abelbour/Abrepuertas/(commit log)

2026-07-19 HW: LED 12V con transistor BC337, actualizada cableado UTP
2026-07-19 HW: LED 12V con transistor BC337 en paneles internos, LED directo 3.3V en externos. Cableado UTP revisado.
2026-07-19 Add mermaid flowcharts and circuit diagrams
2026-07-19 Add circuit diagrams for external panel, gate lock, and emergency pedal
2026-07-19 Convert all flow diagrams to swimlane format
2026-07-20 Audit fixes: LED flash in internal_press, pull-up moved, independent cooldown, FC→OFF handler, emergency race flag, melody timing
2026-07-20 Fix swimlane 11.6: cooldown_externo_activo flag (was LED reposo)
2026-07-20 Reorganize bus: par 1 entradas, par 2 patio, par 3 broadcast, par 4 power
2026-07-20 fix: correcciones de bugs y optimizaciones ESP8266
    - Bugfix: on_boot relay ON para DESACTIVADO (puerta abierta al arrancar)
    - Bugfix: GPIO4 INPUT_PULLUP faltante en pulsador interno
    - Bugfix: emergency_alert usar while no bloqueante en vez de delay()
    - Bugfix: LED control usar make_call().perform() en lambdas
    - Bugfix: unificar rangos on_click interno (>4s sin límite)
    - Bugfix: rtttl.stop previo en unlock_gate para evitar conflicto PWM
    - Bugfix: emergency_alert LED flashea sincronizado con los tonos
    Optimizaciones ESP8266:
    - std::vector<std::string> melodies → PROGMEM melodies.h (~300B DRAM)
    - Cache int ms para doorbell/gate_open (evita FPU emulada)
    - gate_open_flash: mode parallel → s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
    [esphome-gate.yaml]
2026-07-20 feat: nuevas melodias RTTTL, apertura/emergencia RTTTL, bucle emergencia 60s
    - Nuevas 4 melodias de timbre en melodies.h
    - Sonido APERTURA (RTTTL) reemplaza pitidos PWM unlock_gate
    - Sonido EMERGENCIA (RTTTL) reemplaza alarma PWM 800/1200Hz
    - emergency_alert: bucle hasta 60s (12 ciclos) que se corta con
    pulsador interno o FC→OFF
    - Definicion sincronizada (SS5, SS7, diagramas 11.7-11.9)
    - Eliminado flash_and_beep_script (obsoleto tras migracion RTTTL)
    - Globals limpios (beep_pause, beep_step eliminados)
2026-07-20 feat: gate_open_flash beep a RTTTL, ACTIVAR/DESACTIVAR en melodies.h
    - BEEP_FLASH (B5 100ms via RTTTL) reemplaza ultimo PWM directo
    - ACTIVAR y DESACTIVAR movidos a melodies.h como PROGMEM
    - Todos los sonidos del sistema ahora son 100% RTTTL
    - Definicion actualizada (SS3.5, SS10)
2026-07-20 LED sincronizado con melodías en apertura y emergencia
    unlock_gate: LED parpadea 67ms ON/OFF siguiendo patrón c,p de APERTURA
    emergency_alert: LED parpadea 1067ms ON/133ms OFF siguiendo patrón c,8p
    Ambos bucles verifican FC cada 10ms (antes delay ciego en emergencia)
    unlock_gate restaura LED a 25% reposo al finalizar
2026-07-20 buzzer: solo salón (con pot), vestíbulo y patio; exterior sin buzzer
    - Salón: buzzer + pot 10kΩ serie para volumen local
    - Vestíbulo y patio: buzzer directo
    - Exterior: sin buzzer (solo pulsador + LED + alimentación)
    - GPIO14 por par 3 BL/AZ a salón, vestíbulo y patio únicamente
2026-07-20 Update buzzer musical section with wiring details
    Added wiring diagram for buzzer connections in different areas.
2026-07-20 docs: BOM, panel interno completo, pull-up GPIO16, correcciones
    - Añadida Lista de Materiales (§13) con 20 componentes y cantidades
    - Redibujado 11.3 Panel Interno: añade buzzer + pot para salón,
    buzzer directo para vestíbulo, mantiene LED BC337
    - Corregido §6 emergencia: Fast Flash 5s → LED sincronizado
    - Añadido diagrama pull-up GPIO16 10kΩ en vestíbulo (11.6)
    - Renumerado swimlanes 11.6→11.10
    - Swimlanes: TODAS LAS ZONAS → SALÓN/VESTÍBULO/PATIO (exterior sin buzzer)
2026-07-20 fix: LED sincronizado con APERTURA, Flash Rapido a 400ms
    B1: LED en unlock_gate iniciaba OFF — invertido respecto a APERTURA
    (c=67ms ON con LED OFF, p=67ms OFF con LED ON). Ahora LED
    comienza ON sincronizado con la primera nota.
    I1: Strobe Flash Rapido duration 200ms→400ms para coincidir con
    definicion '200ms ON / 200ms OFF'
    [esphome-gate.yaml]
2026-07-20 docs: reordenar secciones — BOM tras HW, distribucion+ cableado tras BOM
    Nuevo orden: Resumen HW → Lista Materiales → Distribución Física
    → Cableado → Asignación Pines → ... → Archivos
    Renumeradas secciones 2-13 y subsecciones 3.x→4.x, 7.x→8.x, 11.x→12.x
2026-07-20 diagrams: swimlane distribution fisica — columnas LR por zona con senales como filas
    Cada zona es una columna (Salon, Vestibulo, Patio, Exterior) con
    direction TB. Las conexiones horizontales entre componentes
    muestran el flujo de senales sobre UTP Cat5. Eliminadas las
    lineas punteadas redundantes MCU -> cada panel.
2026-07-20 fix: swimlane distribucion fisica — componentes agrupados en modulos por zona
2026-07-20 feat: columna Precio y fila Total en Lista de Materiales
2026-07-20 feat: precios de Lega Electronica en Lista de Materiales
2026-07-20 feat: separar precio unitario/subtotal, columna Marca, subtotal a comprar
    Items marcados como Tenemos: NodeMCU, Cerradura, Pulsadores,
    Cable UTP, Cables dupont. Subtotal a comprar = 2.538,10.
2026-07-20 reemplazo BC337 por 2N5551 en Lista de Materiales
    Se actualiza item 12 con 2N5551 (65,55 c/u, 31,10 subtotal).
    Recalculados totales: 17.751,20 general, 2.869,20 a comprar.
2026-07-20 marcar pedal (fabricado con pulsador) y LEDs como ✅; 0 pendientes
2026-07-20 rename SYSTEM_DEFINITION.md -> README.md para portada del repo
2026-07-20 actualizar BC337 -> 2N5551 en circuitos, resumen HW y notas
2026-07-20 cambiar LEDs internos por tiras LED 12V; eliminar R 470Ω
    - Resumen HW: LEDs Estado = tiras 12V internas + LED 3V externos
    - BOM: item LED dividido en 2 tiras + 2 LED 5mm; quitada R 470Ω
    - §4.6: diagrama actualizado (tira LED con resistor incorporado)
    - §12.3: circuito actualizado (tira LED sin R colector)
    - Totales recalculados: 17.420,10 / 2.538,10
2026-07-20 add Lega store links to BOM component names
2026-07-20 BUZ12 + 2N5551 driver: BOM, §4.5, §12.3, §12.4
2026-07-20 PFPSZ subtotal corregido, LED 5mm azul linkeado y priceado
2026-07-21 LED sincronizado con nuevas melodías: 4 ciclos 190/45ms, doc actualizada
2026-07-22 LED externos con driver 2N5551 desde 12V: BOM, circuitos y doc
2026-07-23 Fix FC lógica: ON=abierta OFF=cerrada. YAML + swimlanes corregidos. §4.5 buzzer: señal 3.3V no 12V.
    [esphome-gate.yaml]
2026-07-23 Fix: remove deprecated platform key from esphome block
    [esphome-gate.yaml]
2026-07-23 Fix: board movido a componente esp8266: dedicado
    [esphome-gate.yaml]
2026-07-23 Fix: timer→script con delay (componente timer eliminado en ESPHome nuevo)
    [esphome-gate.yaml]
2026-07-23 Fix: merge timer_reset_melodia en bloque script único
    [esphome-gate.yaml]
2026-07-23 Fix: detener efectos LED antes de cambiar a 25% reposo. Eliminar Flash Rapido redundante en internal_press.
    [esphome-gate.yaml]
2026-07-23 Fix: strobe effect usa colors list en vez de duration directo
    [esphome-gate.yaml]
2026-07-23 Fix: remove initial_value invalido de switch.template, fix rtttl.stop sin argumento
    [esphome-gate.yaml]
2026-07-23 Fix: explicit min_auth_mode WPA2 en wifi
    [esphome-gate.yaml]
2026-07-23 Fix: on_click sin x (split en dos rangos), lock_relay.state reemplazado por global lock_relay_on
    [esphome-gate.yaml]
2026-07-23 Fix: boot seguro ACTIVADO (relay OFF). README tabla estados, Sec.6, BOM res 1kΩ
    [esphome-gate.yaml]
2026-07-23 Doc: dos UTPs (interior + exterior), low-side relay, distancias 8m, BOM actualizada
2026-07-23 Fix: high-side switching, GPIO13 INPUT, FC check inmediato, RTTTL único
    - Issue 1: README actualizado a high-side (UTP2 Par 1 split, GND unificado)
    - Issue 2: internal_press verifica FC inmediatamente tras unlock_gate
    - Issue 3: GPIO13 INPUT_PULLUP → INPUT + pull-up ext 10kΩ, BOM 10kΩ qty 2
    - Issue 4: README refleja RTTTL APERTURA una sola vez antes del while
    - Cleanup: flash_rapid eliminado, diagramas 12.8/12.9 actualizados
    [esphome-gate.yaml]
2026-07-23 Fix: rtttl.stop syntax + yield() en bucles bloqueantes
    - rtttl.stop requiere id: buzzer_rtttl para compilar
    - yield() en unlock_gate while loop evita WDT del ESP8266
    - yield() en emergency_alert inner while loops
    [esphome-gate.yaml]
2026-07-23 Doc: fragmentos YAML inline en secciones 4, 8, 9, 10, 11
    - Section 4: YAML de cada componente (pulsadores, relé, FC, buzzer, LED)
    - Section 8: código YAML real de los 7 scripts + lambda RTTTL dinámico
    - Section 9: endpoints web (/switches, /numbers)
    - Section 10: tabla entities web + tabla de globals del sistema
    - Section 11: APERTURA actualizada a generación dinámica
2026-07-23 Fix: sintaxis mermaid (---|text| → -- text ---, -> → -->)
2026-08-31 Add: timbre_patio.scad caja 50x80x50mm con pestanas y agujeros
    [timbre_patio.scad]
